sulcondr/IoT_Scanner/README.md

# IoT_Scanner
Použitím technologie SDR (softwarového rádia) navrhněte a sestavte prototyp jednoduchého přehledového přijímače a monitoru IoT sítí. Předpokládané funkce přístroje: - Detekce sítí všech IoT standardů v místě přijímače, nalezení přesných frekvencí, přibližné změření intenzity signálu a chybovosti příjmu (infrastrukturních stanic). - Detekce klientských síťových prvků k síti připojených a komunikujících - Výpis přijatých zpráv / paketů (v případě šifrované komunikace bez dešifrování) a jejich přehledné on-line zobrazení - Možnost vzdáleného přístupu a ovládání přijímače přes běžné IP protokoly (tedy ne přes IoT).
