sulcondr/IoT_Scanner/(commit log)

2018-12-31 functional lora frame header and body parsing
2019-01-05 clear button added
